wilbert-alberts/RiksLift/Arduino/floorcontroller/floorcontrollerBack.jpg

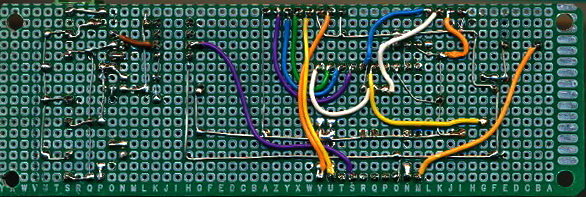
Arduino/floorcontroller/floorcontrollerBack.jpg
