wilbert-alberts/RiksLift/Docs/LiftSystem.png

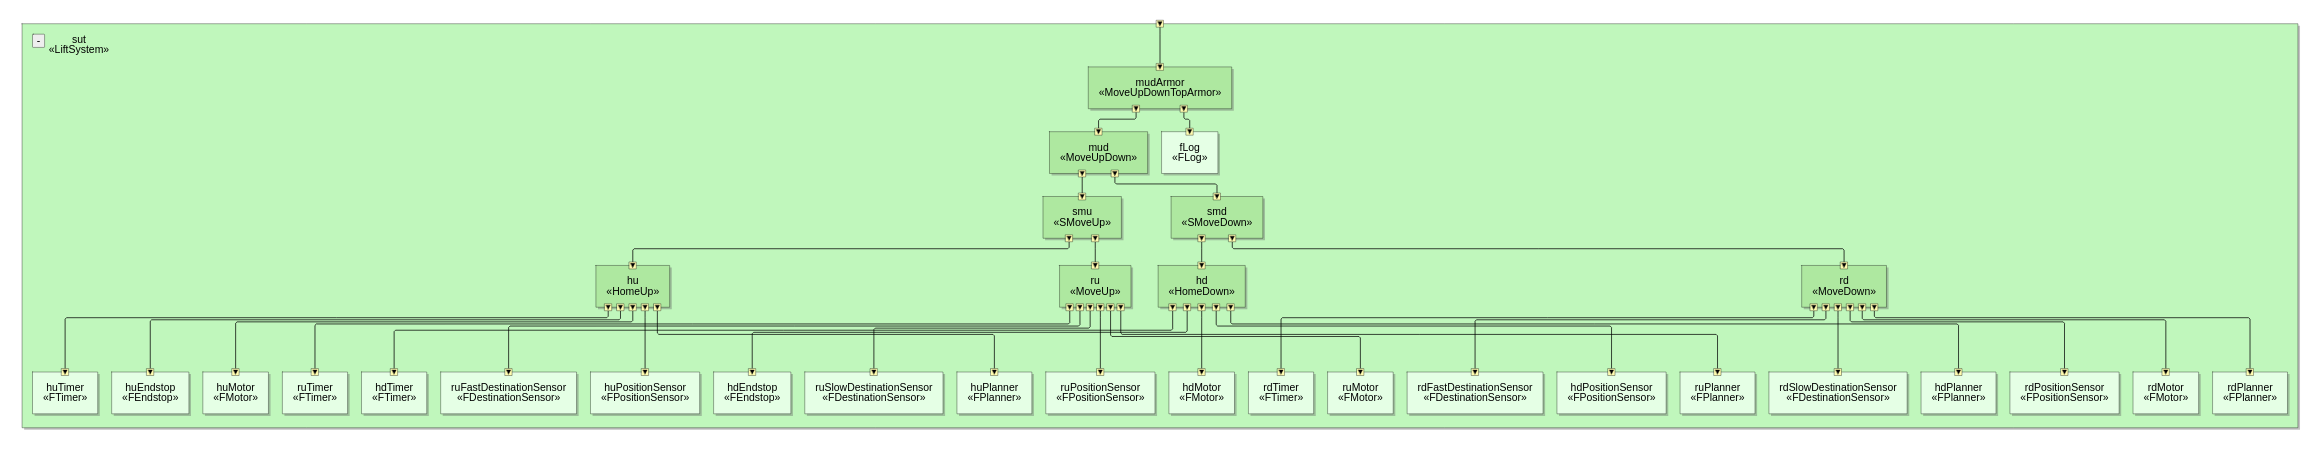
Docs/LiftSystem.png
