wilbert-alberts/RiksLift/Docs/MainSystem.png

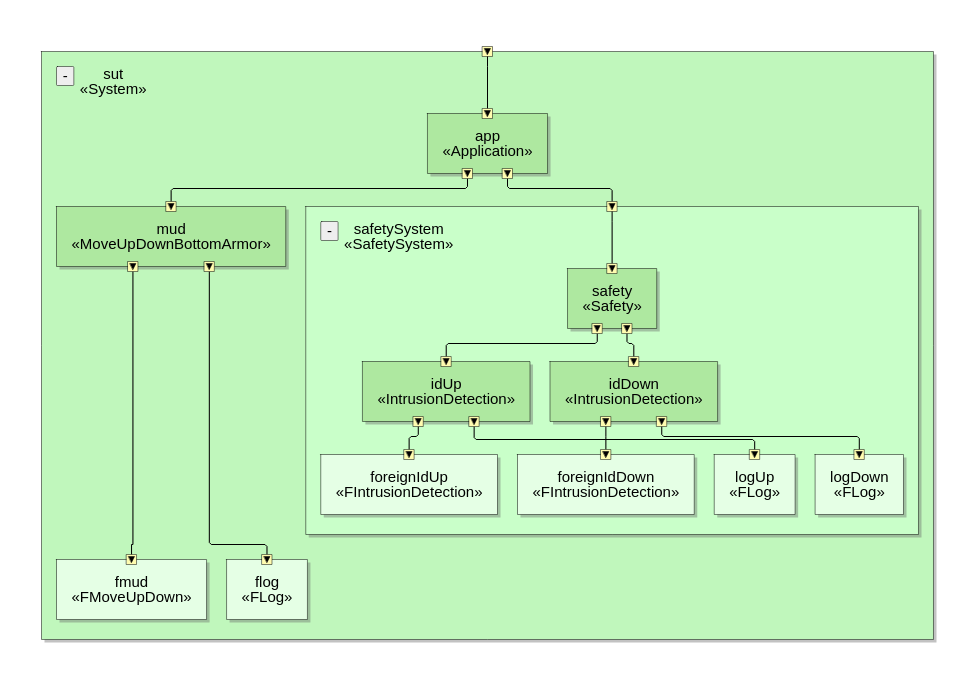
Docs/MainSystem.png
