wilbert-alberts/RiksLift/Arduino/motorcontroller/MotorControllerWithTempSensor.kicad_sch

## KiCad design Arduino/motorcontroller/MotorControllerWithTempSensor.kicad_sch (2024-09-10)

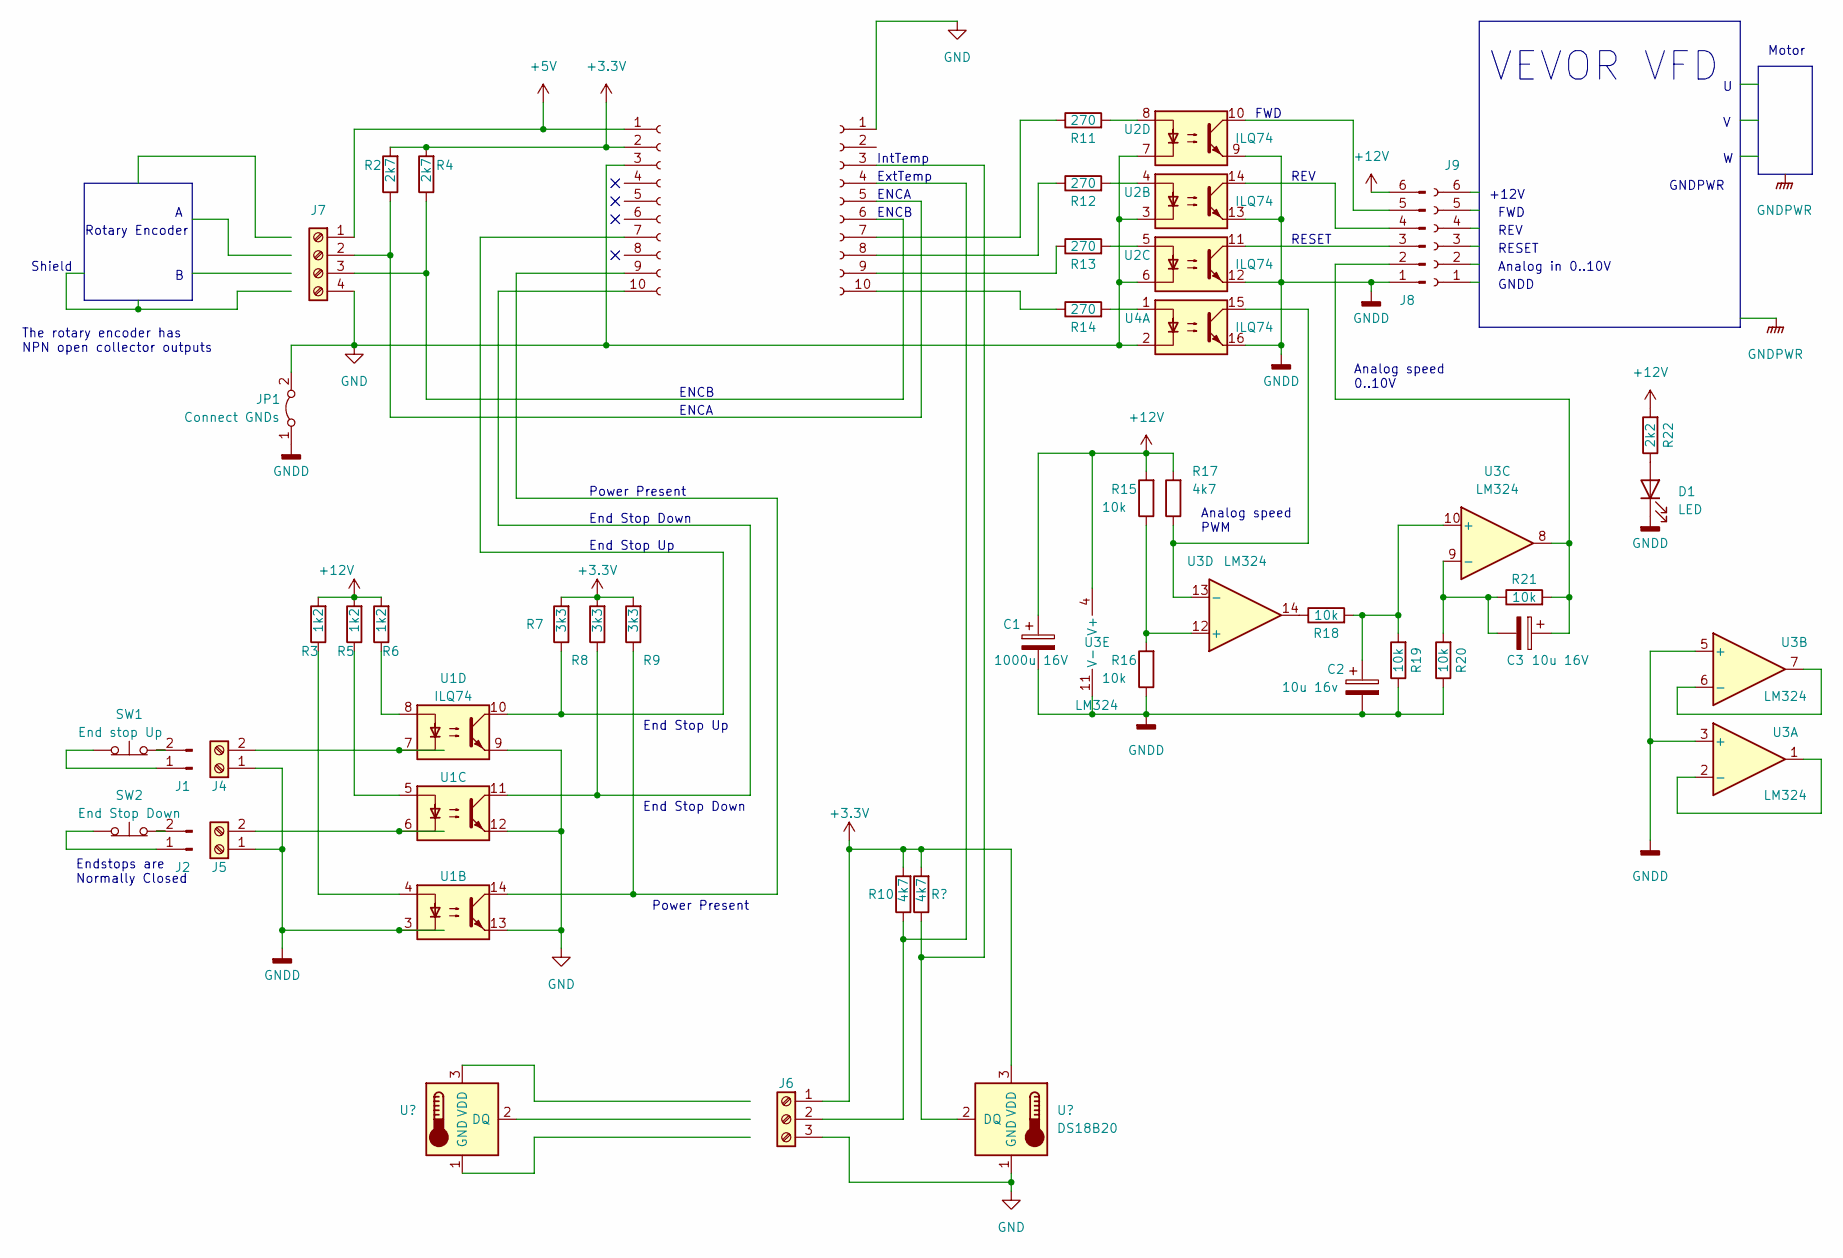
[picture p4: schematic MotorControllerWithTempSensor.kicad_sch]

Parts:
C1: 1000u 16V
C2: 10u 16v
C3: 10u 16V
D1: LED
J1: From ESU
J2: From ESD
J4, J5: Screw_Terminal_01x02
J6: Screw_Terminal_01x03
J7: Screw_Terminal_01x04
J8: From VFD
J9: To VFD
JP1: Connect GNDs
R2, R4: 2k7
R3, R5, R6: 1k2
R7, R8, R9: 3k3
R10, R17: 4k7
R11, R12, R13, R14: 270
R15, R16, R18, R19, R20, R21: 10k
R22: 2k2
SW1: End stop Up
SW2: End Stop Down
U1, U2, U4: ILQ74
U1L1, U1R1: Conn_01x10_Female
U3: LM324

Connections:
+3.3V: R2.2, R4.2, R7.2, R8.2, R9.2, U1L1.2
+5V: J7.1, U1L1.1
+12V: C1.1, J8.6, R3.2, R5.2, R6.2, R15.2, R17.2, R22.2, U3.4 (V+)
GND: J7.4, JP1.2 (B), U1.9, U1.12, U1.13, U1L1.3, U1R1.1, U2.3, U2.6, U2.7, U4.2
GNDD: C1.2, C2.2, D1.1 (K), J4.1, J5.1, J8.1, JP1.1 (A), R16.1, R19.1, R20.1, U1.3, U2.9, U2.12, U2.13, U3.3 (+), U3.5 (+), U3.11 (V-), U4.16
unnamed: C2.1, R18.2, R19.2, U3.10 (+)
unnamed: C3.1, J8.2, R21.2, U3.8
unnamed: C3.2, R20.2, R21.1, U3.9 (-)
unnamed: D1.2 (A), R22.1
unnamed: J1.1, SW1.1 (A)
unnamed: J1.2, SW1.2 (B)
unnamed: J2.1, SW2.1 (A)
unnamed: J2.2, SW2.2 (B)
unnamed: J4.2, U1.7
unnamed: J5.2, U1.6
unnamed: J6.1, R10.2
unnamed: J6.2, R10.1, U1R1.4
unnamed: J7.2, R2.1, U1R1.5
unnamed: J7.3, R4.1, U1R1.6
unnamed: J8.3, U2.11
unnamed: J8.4, U2.14
unnamed: J8.5, U2.10
unnamed: R3.1, U1.4
unnamed: R5.1, U1.5
unnamed: R6.1, U1.8
unnamed: R7.1, U1.10, U1L1.7
unnamed: R8.1, U1.11, U1L1.10
unnamed: R9.1, U1.14, U1L1.9
unnamed: R11.1, U1R1.7
unnamed: R11.2, U2.8
unnamed: R12.1, U1R1.8
unnamed: R12.2, U2.4
unnamed: R13.1, U1R1.9
unnamed: R13.2, U2.5
unnamed: R14.1, U1R1.10
unnamed: R14.2, U4.1
unnamed: R15.1, R16.2, U3.12 (+)
unnamed: R17.1, U3.13 (-), U4.15
unnamed: R18.1, U3.14
unnamed: U3.1, U3.2 (-)
unnamed: U3.6 (-), U3.7

Notes on the sheet:
ENCA
Power Present
Analog speed 0..10V
RESET
End Stop Down
ExtTemp
FWD
Rotary Encoder
VEVOR VFD
End Stop Up
Shield
ENCB
REV
The rotary encoder has NPN open collector outputs
Analog speed PWM
GNDD
+12V
Endstops are Normally Closed
Analog in 0..10V
Motor
GNDPWR
IntTemp
