wilbert-alberts/RiksLift/LiftSystem/FDestinationSensor.cpp

#include "LiftSystem.hh"

FDestinationSensor::FDestinationSensor(dzn::locator const &locator)
    : skel::FDestinationSensor(locator) {

      };

FDestinationSensor::~FDestinationSensor() {

};

void FDestinationSensor::p_setDestination(Position posInM)
{
  /* TODO*/
}

void FDestinationSensor::p_cancelDestination()
{
  /* TODO*/
}
