wilbert-alberts/RiksLift/Arduino/floorcontroller/tester.h

//
// tester.h -- command based tester for RiksLift
//
// BSla, 9 aug 2024
#ifndef _TESTER_H
#define _TESTER_H

#include <Arduino.h>

class Tester {
  public:
   void setup ();
   void loop ();
  private:


};

extern Tester tester;

#endif
