wilbert-alberts/RiksLift/(commit log)

2024-08-27 Fix: first distributed version that really builds.
    [FButton.cpp, FButton.h, FIntrusionDetection.cpp, FileLogger.h, Foreign.h, MQTTBridge.cpp]
2024-09-03 fix: initial esp implementation of foreigns.
    [FDestinationSensor.cpp, FMoveUpDown.cpp, FMoveUpDown.h, Foreign.h]
2024-09-05 wip: need to connect endstop and position sensor. Maybe it's better to connect specific endstop to specific positions sensors.
2024-09-05 fix: implemented all foreign systems up to not inc. Hardware.
    [FDestinationSensor.cpp, main.cpp]
2024-09-10 fix: copy paste bug in HomeDown and DZN path difference.
    [main.cpp]
2024-09-10 fix: ensure Liftsystem FDestinationSensor is compliant.
    [FDestinationSensor.cpp]
2024-09-10 Feature: added legacy Arduino version
    [MotorControllerWithTempSensor.kicad_sch]
2024-09-10 fix: add necessary files to get started.
    [brokerlink.cpp, debug.cpp, hsi.h, liftglobals.cpp]
2024-09-17 fix: revert to unique_ptr
    [main.cpp]
2024-09-24 fix: connect to broker and subscribe.
    [main.cpp]
2024-10-08 Foreign code connected to basic hardware interface code Fixed bugs in homing move up/down code
    [main.cpp]
2024-10-15 Debugging: home up/down succeeds, move after home still fails. Endstop positions not set
    [main.cpp]
2024-10-22 fix: more or less working version.
    See remaining issues on github.
    [main.cpp]
2024-10-29 Fix #6 Simulator lift position expressed in float [m] instead of int32 [incs]
    [main.cpp]
2024-11-05 fix: Prototype of stream based dezyne debug.
    [main.cpp]
2024-11-05 fix: improve visibility of debug
    [main.cpp]
